gerdb/tinnitus32/pics/power_supply.png

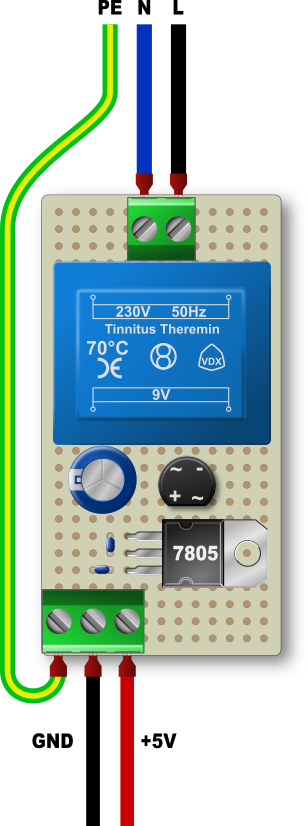
pics/power_supply.png
