gerdb/tinnitus32/pics/power_supply_sch.png

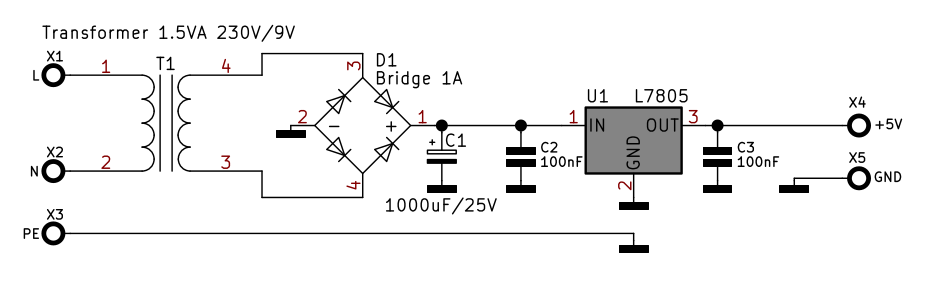
pics/power_supply_sch.png
