gerdb/tinnitus32/pics/stm32F407_disco.png

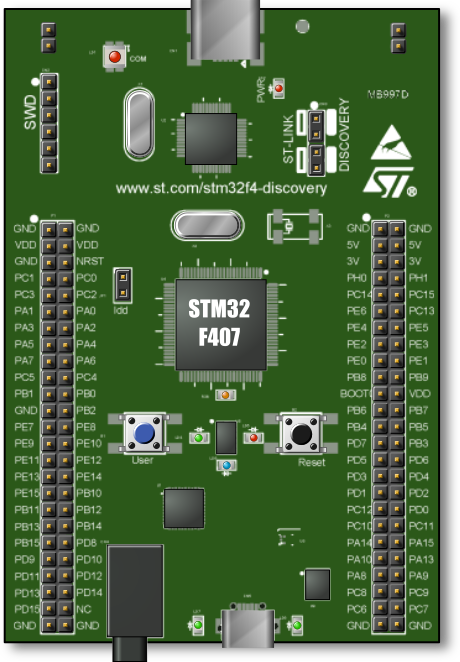
pics/stm32F407_disco.png
