gerdb/tinnitus32/pics/tinnitus_osc_pcb.png

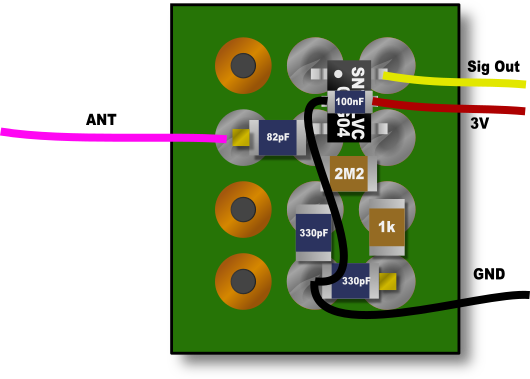
pics/tinnitus_osc_pcb.png
