gerdb/tinnitus32/(threads)

Thread 10 (2018-01-07):

Create and test a design for simple LC oscillator

gerdb, 2018-01-07:
Test it with different capacities

Closed 2018-05-20.

Thread 3 (2018-01-07):

Support of volume pitch and/or shift

gerdb, 2018-01-07:
It should be possible to adapt the volume range to adapt it to different oscillators. Is it necessary to have a volume zoom AND shift pot?
Calculation of volume table could be done in 1ms task.

gerdb, 2018-01-08:
Implemented only scale/zoom

Closed 2018-01-08.

Thread 7 (2018-01-07):

Create a PCB

gerdb, 2018-01-07:
PCB with multiplexers and maybe an STM32F407, so that it could be build up without discovery board.

gerdb, 2018-06-14:
Project should be without PCB

Closed 2018-06-14.

Thread 8 (2018-01-07):

Create front panel design with USB socket and a 3.5/6.35mm headphone jack

gerdb, 2018-01-07:
Update the front panel to a tinnitus basic device.

gerdb, 2018-01-14:
Don't forget the auto-tune knob and maybe a mute switch.

gerdb, 2018-02-16:
Created

Closed 2018-02-16.
