gerdb/tinnitus32/Hardware/Frontpanel/Fontpanel_Basic.pdf

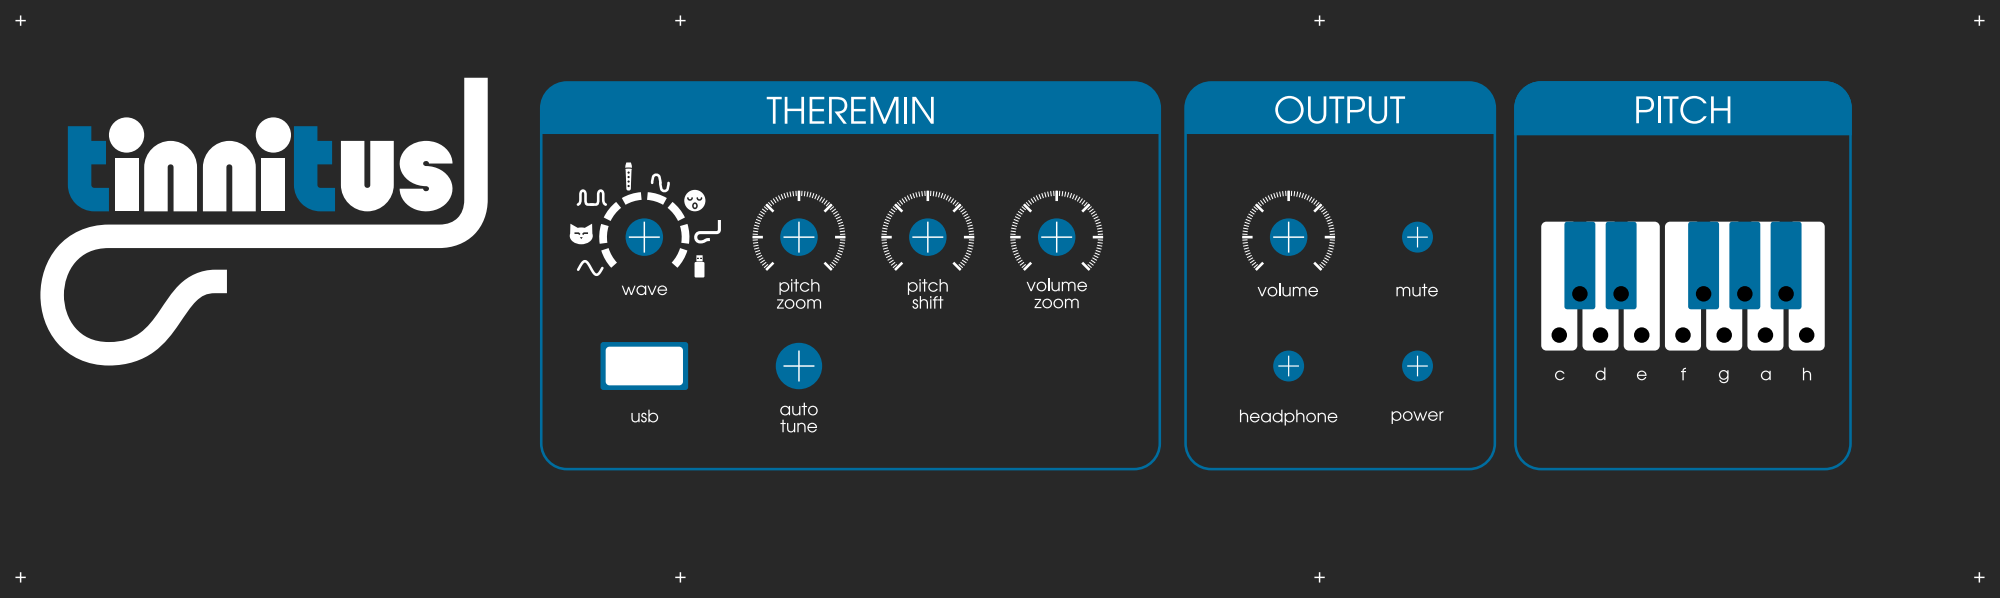
[picture p17: page 1]
