gerdb/tinnitus32/Software/tinnitus32.ioc

Mcu.UserName=STM32F407VGTx
PA0-WKUP.GPIO_Label=B1 [Blue PushButton]
PA0-WKUP.Signal=GPXTI0
PA1.GPIO_Label=ANALOG_1
PA1.Signal=ADCx_IN1
PA10.GPIO_Label=OTG_FS_ID
PA10.Signal=USB_OTG_FS_ID
PA11.GPIO_Label=OTG_FS_DM
PA11.Signal=USB_OTG_FS_DM
PA12.GPIO_Label=OTG_FS_DP
PA12.Signal=USB_OTG_FS_DP
PA13.GPIO_Label=SWDIO
PA13.Signal=SYS_JTMS-SWDIO
PA14.GPIO_Label=SWCLK
PA14.Signal=SYS_JTCK-SWCLK
PA2.GPIO_Label=ANALOG_2
PA2.Signal=ADCx_IN2
PA3.GPIO_Label=ANALOG_3
PA3.Signal=ADCx_IN3
PA4.GPIO_Label=I2S3_WS [CS43L22_LRCK]
PA4.Signal=I2S3_WS
PA5.GPIO_Label=SPI1_SCK [LIS302DL_SCL/SPC]
PA5.Signal=SPI1_SCK
PA6.GPIO_Label=SPI1_MISO [LIS302DL_SDO]
PA6.Signal=SPI1_MISO
PA7.GPIO_Label=SPI1_MOSI [LIS302DL_SDA/SDI/SDO]
PA7.Signal=SPI1_MOSI
PA9.GPIO_Label=VBUS_FS
PA9.Signal=USB_OTG_FS_VBUS
PB0.GPIO_Label=ANALOG_6
PB0.Signal=ADCx_IN8
PB1.GPIO_Label=ANALOG_7
PB1.Signal=ADCx_IN9
PB10.GPIO_Label=CLK_IN [MP45DT02_CLK]
PB10.Signal=I2S2_CK
PB11.GPIO_Label=PITCH_LED_3
PB11.Signal=GPIO_Output
PB12.GPIO_Label=PITCH_LED_4
PB12.Signal=GPIO_Output
PB13.GPIO_Label=PITCH_LED_5
PB13.Signal=GPIO_Output
PB14.GPIO_Label=PITCH_LED_6
PB14.Signal=GPIO_Output
PB15.GPIO_Label=PITCH_LED_7
PB15.Signal=GPIO_Output
PB2.GPIO_Label=BOOT1
PB2.Signal=GPIO_Input
PB3.GPIO_Label=SWO
PB3.Signal=SYS_JTDO-SWO
PB6.GPIO_Label=Audio_SCL [CS43L22_SCL]
PB6.Signal=I2C1_SCL
PB9.GPIO_Label=Audio_SDA [CS43L22_SDA]
PB9.Signal=I2C1_SDA
PC0.GPIO_Label=OTG_FS_PowerSwitchOn
PC0.Signal=GPIO_Output
PC1.GPIO_Label=ANALOG_8
PC1.Signal=ADCx_IN11
PC10.GPIO_Label=I2S3_SCK [CS43L22_SCLK]
PC10.Signal=I2S3_CK
PC12.GPIO_Label=I2S3_SD [CS43L22_SDIN]
PC12.Signal=I2S3_SD
PC14-OSC32_IN.GPIO_Label=PC14-OSC32_IN
PC14-OSC32_IN.Signal=RCC_OSC32_IN
PC15-OSC32_OUT.GPIO_Label=PC15-OSC32_OUT
PC15-OSC32_OUT.Signal=RCC_OSC32_OUT
PC2.GPIO_Label=ANALOG_9
PC2.Signal=ADCx_IN12
PC3.GPIO_Label=PDM_OUT [MP45DT02_DOUT]
PC3.Signal=I2S2_SD
PC4.GPIO_Label=ANALOG_4
PC4.Signal=ADCx_IN14
PC5.GPIO_Label=ANALOG_5
PC5.Signal=ADCx_IN15
PC6.GPIO_Label=POT_MUX_A
PC6.Signal=GPIO_Output
PC7.GPIO_Label=I2S3_MCK [CS43L22_MCLK]
PC7.Signal=I2S3_MCK
PC8.GPIO_Label=POT_MUX_B
PC8.Signal=GPIO_Output
PC9.GPIO_Label=POT_MUX_C
PC9.Signal=GPIO_Output
PD10.GPIO_Label=PITCH_LED_10
PD10.Signal=GPIO_Output
PD11.GPIO_Label=PITCH_LED_11
PD11.Signal=GPIO_Output
PD12.GPIO_Label=LD4 [Green Led]
PD12.Signal=GPIO_Output
PD13.GPIO_Label=LD3 [Orange Led]
PD13.Signal=GPIO_Output
PD14.GPIO_Label=LD5 [Red Led]
PD14.Signal=GPIO_Output
PD15.GPIO_Label=LD6 [Blue Led]
PD15.Signal=GPIO_Output
PD4.GPIO_Label=Audio_RST [CS43L22_RESET]
PD4.Signal=GPIO_Output
PD5.GPIO_Label=OTG_FS_OverCurrent
PD5.Signal=GPIO_Input
PD8.GPIO_Label=PITCH_LED_8
PD8.Signal=GPIO_Output
PD9.GPIO_Label=PITCH_LED_9
PD9.Signal=GPIO_Output
PE1.GPIO_Label=MEMS_INT2 [LIS302DL_INT2]
PE1.Signal=GPXTI1
PE11.GPIO_Label=VOLUME_OSC
PE11.Signal=S_TIM1_CH2
PE12.GPIO_Label=PITCH_LED_0
PE12.Signal=GPIO_Output
PE13.GPIO_Label=TIMBRE_OSC
PE13.Signal=S_TIM1_CH3
PE14.GPIO_Label=PITCH_LED_1
PE14.Signal=GPIO_Output
PE15.GPIO_Label=PITCH_LED_2
PE15.Signal=GPIO_Output
PE3.GPIO_Label=CS_I2C/SPI [LIS302DL_CS_I2C/SPI]
PE3.Signal=GPIO_Output
PE9.GPIO_Label=PITCH_OSC
PE9.Signal=S_TIM1_CH1
PH0-OSC_IN.GPIO_Label=PH0-OSC_IN
PH0-OSC_IN.Signal=RCC_OSC_IN
PH1-OSC_OUT.GPIO_Label=PH1-OSC_OUT
PH1-OSC_OUT.Signal=RCC_OSC_OUT
