gerdb/tinnitus32/Software/Inc/config.h

/**
 *  Project     tinnitus32
 *  @file		config.h
 *  @author		Gerd Bartelt - www.sebulli.com
 *  @brief		Header file for config.c
 *
 *  @copyright	GPL3
 *
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
 */
#ifndef CONFIG_H_
#define CONFIG_H_

/* Constants ------------------------------------------------------------ */
#define VERSION_MAJOR	0
#define VERSION_MINOR	0
#define VERSION_BUILD	1


// Virtual EEProm addresses. 32bit values need 2 addresses
#define EEPROM_ADDR_PITCH_AUTOTUNE_H	0
#define EEPROM_ADDR_PITCH_AUTOTUNE_L	1
#define EEPROM_ADDR_VOL_AUTOTUNE_H		2
#define EEPROM_ADDR_VOL_AUTOTUNE_L		3
// !! Update also NB_OF_VAR in eeprom.h !!


/* Types ---------------------------------------------------------------- */
typedef struct
{
  int32_t   Version;
  int32_t   VolumeShift;
  int32_t   cfg02;
  int32_t   cfg03;
  int32_t   cfg04;
  int32_t   cfg05;
  int32_t   cfg06;
  int32_t   cfg07;
  int32_t   cfg08;
  int32_t   cfg09;
  int32_t   cfg10;
  int32_t   cfg11;
  int32_t   cfg12;
  int32_t   cfg13;
  int32_t   cfg14;
  int32_t   cfg15;

  int32_t   cfg16;
  int32_t   cfg17;
  int32_t   cfg18;
  int32_t   cfg19;
  int32_t   cfg20;
  int32_t   cfg21;
  int32_t   cfg22;
  int32_t   cfg23;
  int32_t   cfg24;
  int32_t   cfg25;
  int32_t   cfg26;
  int32_t   cfg27;
  int32_t   cfg28;
  int32_t   cfg29;
  int32_t   cfg30;
  int32_t   cfg31;

  int32_t   cfg32;
  int32_t   cfg33;
  int32_t   cfg34;
  int32_t   cfg35;
  int32_t   cfg36;
  int32_t   cfg37;
  int32_t   cfg38;
  int32_t   cfg39;
  int32_t   cfg40;
  int32_t   cfg41;
  int32_t   cfg42;
  int32_t   cfg43;
  int32_t   cfg44;
  int32_t   cfg45;
  int32_t   cfg46;
  int32_t   cfg47;

  int32_t   cfg48;
  int32_t   cfg49;
  int32_t   cfg50;
  int32_t   cfg51;
  int32_t   cfg52;
  int32_t   cfg53;
  int32_t   cfg54;
  int32_t   cfg55;
  int32_t   cfg56;
  int32_t   cfg57;
  int32_t   cfg58;
  int32_t   cfg59;
  int32_t   cfg60;
  int32_t   cfg61;
  int32_t   cfg62;
  int32_t   cfg63;
}CONFIG_TypeDef;


/* global variables ----------------------------------------------------- */
volatile extern const CONFIG_TypeDef __attribute__((section (".myConfigSection"))) CONFIG;

/* Function prototypes ----------------------------------------------------- */
void CONFIG_Init(void);
void CONFIG_Write_SLong(int addr, int32_t value);
int32_t CONFIG_Read_SLong(int addr);

#endif /* CONFIG_H_ */
