gerdb/tinnitus32/Software/Src/audio_out.c

/**
 *  Project     tinnitus32
 *  @file		audio_out.c
 *  @author		Gerd Bartelt - www.sebulli.com
 *  @brief		Outputs the digital audio data to DAC
 *
 *  @copyright	GPL3
 *
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
 */

#include "../Drivers/BSP/Components/cs43l22/cs43l22.h"
#include "../Drivers/BSP/STM32F4-Discovery/stm32f4_discovery.h"
#include "../Drivers/BSP/Components/Common/audio.h"
#include "stm32f4xx_hal.h"
#include "audio_out.h"
#include "theremin.h"
#include "pots.h"
#include <math.h>

__IO uint32_t I2S_DR;

static AUDIO_DrvTypeDef           *pAudioDrv;

/* Initial Volume level (from 0 (Mute) to 100 (Max)) */
static uint8_t Volume = 60;

extern I2S_HandleTypeDef hi2s3;
int bMute = 0;

void AUDIO_OUT_Init(void)
{
	  uint8_t ret = AUDIO_OK;

	  if(ret == AUDIO_OK)
	  {
	    /* Retieve audio codec identifier */
	    if(((cs43l22_drv.ReadID(AUDIO_I2C_ADDRESS)) & CS43L22_ID_MASK) == CS43L22_ID)
	    {
	      /* Initialize the audio driver structure */
	      pAudioDrv = &cs43l22_drv;
	    }
	    else
	    {
	      ret = AUDIO_ERROR;
	    }
	  }

	  if(ret == AUDIO_OK)
	  {
	    pAudioDrv->Init(AUDIO_I2C_ADDRESS, OUTPUT_DEVICE_HEADPHONE, Volume, 48000);
	  }

	  if(ret == AUDIO_OK)
	  {
		  /* Call the audio Codec Play function */
		  if(pAudioDrv->Play(AUDIO_I2C_ADDRESS, 0, 0) != 0)
		  {
			  ret = AUDIO_ERROR;
		  }
		  else
		  {
		    /* Update the Media layer and enable it for play */
		    //HAL_I2S_Transmit_DMA(&hAudioOutI2s, pBuffer, DMA_MAX(Size/AUDIODATA_SIZE));

		    /* Return AUDIO_OK when all operations are correctly done */
		    ret = AUDIO_OK;
		  }
	  }

	  if(ret == AUDIO_OK)
	  {
		    /* Enable TXE and ERR interrupt */
		    __HAL_I2S_ENABLE_IT(&hi2s3, (I2S_IT_TXE | I2S_IT_ERR));

		    /* Check if the I2S is already enabled */
		    if((hi2s3.Instance->I2SCFGR &SPI_I2SCFGR_I2SE) != SPI_I2SCFGR_I2SE)
		    {
		      /* Enable I2S peripheral */
		      __HAL_I2S_ENABLE(&hi2s3);
		    }

		    hi2s3.Instance->DR = 0;
	  }

	  // Set the volume pot from 0.. 85
	  strPots[POT_VOLUME_OUT].iMaxValue = 85;
}

/*
 * @brief 1ms Task to set the volume of the DAC headphone amplifier
 *
 */
void AUDIO_OUT_1msTask(void)
{
	if (POTS_HasChanged(POT_VOLUME_OUT)) {
		float vol =  ((float)POTS_GetScaledValue(POT_VOLUME_OUT))/85.0f;
		vol = powf(vol, 0.2f);
		pAudioDrv->SetVolume(AUDIO_I2C_ADDRESS,vol * 85);
	}
}

/*
 * This IRQ Handler is called every 96kHz, to send a new sample
 *  first left then right audio channel to the DAC over the I2S bus.
 *  The Audio frequency is 48kHz
 */
void AUDIO_OUT_I2S_IRQHandler(void)
{
	if (bMute)
	{
		hi2s3.Instance->DR = 0;
	}
	else
	{
		// Fill the audio DAC
		hi2s3.Instance->DR = usDACValue;
	}

	// Get the new value for the next task
	THEREMIN_96kHzDACTask();
}
