gerdb/tinnitus32/(commit log)

2017-12-16 Sin wavetable and compiler settings
    [Theremin32 Debug.cfg]
2017-12-24 Semihosting enabled, Filter for pitch
    [Theremin32 Debug Semihosting.cfg]
2017-12-24 Autotune for pitch
2017-12-25 First playable theremin with volume, pitch and auto-tune. Still without linearization.
2017-12-25 Pitch linearization
2017-12-29 Scaled pitch
2017-12-29 Renamed project to "tinnitus32"
    [tinnitus32 Debug Semihosting.cfg, tinnitus32 Debug.cfg]
2017-12-29 Re-factored and commented the source code. New module "theremin"
    [Softwaretinnitus32 Debug Semihosting.cfg, Softwaretinnitus32 Debug.cfg]
2017-12-30 USB host support. ADC prepared.
2017-12-30 removed debug configurations from root
    [Softwaretinnitus32 Debug Semihosting.cfg, Softwaretinnitus32 Debug.cfg]
2018-01-01 Reads 9 ADC channels with DMA, but without IRQ
2018-01-01 Audio DAC has highest interrupt priority (higher than USB)
2018-01-02 Updated project description with schematics. 1sec auto-tune
2018-01-03 Added BOM
2018-01-04 Pin maps and image of tinnitus32 basic
2018-01-06 Wav table should have at least 4096 entries for less noise (or we must implement some kind of interpolation)
    [main.c, theremin.c]
2018-01-06 Added auto tune button
2018-01-07 Pitch zooming/scaling
2018-01-07 Removed old pitch linearization with LUT
2018-01-07 Pitch shift
2018-01-07 Added download link for STM32 programming tool
2018-01-13 Save and restore auto-tune values after power off/on
2018-01-14 Additional low pass filter after volume table to avoid aliasing noise
    [theremin.c]
2018-01-14 Pitch pow() as LUT. Mute. Wave-table with interpolation
2018-01-21 Filter over wavetable. Float access to points of wavetable.
2018-01-21 Update the pot value only if the scaled value has changed. Also prevent of double updating tables when 2 table parameters have changed.
    [pots.c, pots.h, theremin.c]
2018-01-21 Low pass filter wave tables with individual paramters. Mute during waveform calculation
2018-01-21 Low pass filtered sawtooth
2018-02-11 Bugfix interpolation pitch table. Frontpanel for basic variant.
    [theremin.c]
2018-02-15 Frontpanel with power and mute knobs.
2018-03-18 Frontpanel as pdf, oscillator with SN74LVC1GX04, LFO
    [theremin.c, theremin.h]
2018-05-10 12 new Outputs for pitch LEDs. Added CubeMX Report
2018-05-10 Added example of setting PITCH LED
2018-05-10 Extra function for pitch LED display
2018-05-16 Removed DEBUG compiler switch
2018-05-17 LED Pitch display
2018-05-20 Description for LED display
2018-05-20 Added front panel and case information
2018-06-15 THD oscillator, LEDs
2018-06-15 Added power supply suggestion.
2018-06-16 Added schematic power supply
2018-06-16 10R/1uF Input Filter
2018-06-16 Added 10R resistor to PCB
2018-06-17 Moved power supply to Wiki
